kimchicon/BadgeHacking/PARTS/BADGE_PARTS_LIST.xlsx

 | 종류 | 모델명 | 개당(해외) | 개당(국내) | 주문개수 | 총 금액(해외) | 총 금액(국내) | 배송비 | URL
배송완료 | MCU | ATMEGA32U4 | $2.61 |  | 10pcs x 21개 | $652.63 |  | $45.52 | http://bit.ly/24hznVF
배송완료 | WIFI | ESP-12E | $2.04 |  | 10pcs x 21개 | $423.78 |  | $17.47 | http://bit.ly/1RT7o7r
배송완료 | TFT-LCD | ST7735 호환 | $3.29 |  | 210개 | $690.9 |  | $50 | http://bit.ly/1TNyb7s
배송완료 | 조이스틱 | KY-023 | $1.20 |  | 210개 | $252 |  | $22 | http://bit.ly/1sphjNz
배송완료 | 버튼 | PUSH BUTTON | $0.20 |  | 100pcs x 5개 | $42.50 |  | $30.13 | http://bit.ly/1Xbbxw0
배송완료 | 스위치 | Tact switch | $0.02 |  | 300개 | $5.16 |  | $30.13 | http://bit.ly/20Rgckx
배송완료 | 스위치 | SLIDE SWITCH (충전용) | $0.09 |  | 250개 | $19.40 |  | $15.06 | http://bit.ly/1U4exYg
배송완료 | 충전회로 | MCP73781 | $0.29 |  | 300개 | $83.43 |  | $40.00 | http://bit.ly/1Ur7IyD
배송완료 | REG | REG LDO 3.3 | $0.26 |  | 300개 | $51.87 |  | 묶음 배송 | http://bit.ly/1THVgZ7
배송완료 | 다이오드 | B340A | $0.04 |  | 500개 | $20 |  | $21.08 | http://bit.ly/1RICbnj
배송완료 | 크리스탈 | CSTCE 16Mhz | $0.37 |  | 220개 | $79.75 |  | $39.82 | http://bit.ly/1Y9wNBw
배송완료 | USB | USB-A | $0.11 |  | 210개 | $22.47 |  | $23.94 | http://bit.ly/1sueJ8V
배송완료 | 저항 | 10k | $0.01 |  | 600개 | $1.50 |  | $19.58 | http://goo.gl/MGPy3l
배송완료 | 저항 | 330 | $0.01 |  | 1000개 | $2.50 |  | 묶음 배송 | http://goo.gl/hWQtdl
배송완료 | 저항 | 22 | $0.01 |  | 600개 | $1.50 |  | 묶음 배송 | http://goo.gl/9OESeV,
배송완료 | 캐패시터 | 4.7uF | $0.02 |  | 400개 | $8.50 |  | $23.03 | http://goo.gl/saezLJ,
배송완료 | 캐패시터 | 0.1uF(100nF) | $0.01 |  | 700개 | $2.73 |  | 묶음 배송 | http://goo.gl/LYKlRL,
배송완료 | 캐패시터 | 1uF | $0.02 |  | 400개 | $4.24 |  | 묶음 배송 | http://goo.gl/xDU011,
배송완료 | 캐패시터 | 470pF | $0.01 |  | 400개 | 1.92 |  | $18.07 | http://goo.gl/welw40
배송완료 | 캐패시터 | 4.7uF | $0.02 |  | 600개 | $5.72 |  | 묶음 배송 | http://goo.gl/U0hsCX
배송완료 | LED | SMD TYPE | $0.20 |  | 600pcs x 4 | $ 26.60 |  | $22.76 | http://bit.ly/1UamMhJ
배송완료 | 핀 | 핀헤더 | $0.08 |  | 210개 | $17.00 |  | $30 | http://bit.ly/1YcdtDw
배송완료 | 핀 | 핀 커넥터 8 | $1.69 |  | 20pcs x 20 | $21.89 |  | $14.59 | http://goo.gl/okwCfy
배송완료 | 핀 | 핀 커넥터 4 | $0.05 |  | 140개 | $ 7.77 |  | $15.66 | http://goo.gl/9sksXs
배송완료 | 배터리 | LiPo 3.7V 1500mAh | $3.35 |  | 210개 | $667 |  | $92 | http://bit.ly/1WF3ZkC
배송완료 | 부저 | 피에조 부저 | $0.60 |  | 220개 | $117.48 |  | $18.07 | http://bit.ly/2a1lYSf
배송완료 | 쉬프트reg | 74HC595D (http://www.aliexpress.com/item/Free-shipping-10pcs-74HC595-SMD-logic-ics-74HC595D/32344291871.html) |  | 320 | 105개 |  | 33600 |  | http://www.devicemart.co.kr/1056859
배송완료 | 저항 | 330 |  | 200 |  |  | 4000 |  | http://www.devicemart.co.kr/25679
배송완료 | 저항 | 10m |  | 300 |  |  | 7000 |  | http://www.devicemart.co.kr/26851
배송완료 | 저항 | 10k |  | 200 |  |  | 4000 |  | http://www.devicemart.co.kr/25876
배송완료 | 커넥터 | 핀 커넥터 |  | 100 |  |  | 13750 |  | http://itempage.auction.co.kr/detailview.aspx?ItemNo=B300615427
배송완료 | LED | 8LED |  | 50 | 1800개 |  | 90000 |  | http://www.devicemart.co.kr/29835
배송완료 | 캐패시터 | 2.2uF |  | 19 | 600개 |  | 11400 |  | http://www.devicemart.co.kr/39625
배송완료 | 캐패시터 | 18pF |  | 7 | 200개 |  | 1400 |  | http://www.devicemart.co.kr/5166
배송완료 | 캐패시터 | 10nF |  | 7 | 200개 |  | 1400 |  | http://www.devicemart.co.kr/34758
배송완료 | 캐패시터 | 0.1uF(100nF) |  | 7 | 100개 |  | 700 |  | http://www.devicemart.co.kr/8088
배송완료 | 캐패시터 | 1nF |  | 7 | 700개 |  | 4900 |  | http://www.devicemart.co.kr/5196
배송완료 | 캐패시터 | 10pF |  | 7 | 100개 |  | 700 |  | http://www.devicemart.co.kr/5163
배송완료 | 캐패시터 | 20pF |  | 7 | 500개 |  | 3500 |  | http://www.devicemart.co.kr/5167
배송완료 | 캐패시터 | 10nF |  | 7 | 100개 |  | 700 |  | http://www.devicemart.co.kr/5210
배송완료 | 캐패시터 | 47nF |  | 14 | 100개 |  | 1400 |  | http://www.devicemart.co.kr/5213
배송완료 | 캐패시터 | 100nF |  | 90 | 200개 |  | 18000 |  | http://itempage.auction.co.kr/detailview.aspx?ItemNo=B293336125
배송완료 | USB | Micro USB B-type |  | 230 | 210개 |  | 55630 |  | http://itempage3.auction.co.kr/DetailView.aspx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
배송완료 | 목줄 | 1m USB 케이블 |  | 780 | 210개 |  | 179680 |  | http://bit.ly/1Y0Kwdy
 | PCB + SMT |  |  | 9500 |  |  | 2186250 |  | 한샘디지텍
 | 샘플 PCB 제작 |  |  |  |  |  | 184800 |  | 한샘디지텍
 | 합계 |  |  |  |  | 3666362.49 | $2802810.00 | 652763.28
 |  |  |  |  |  |  | 최종금액 | 7121935.77
