kimchicon/BadgeHacking/PINMAP/BADGE_PIN_MAP.xlsx

NAME | FUNCTION | CONNECTION
D0 | RXD1/AIN1/INT2 | ESP8266-TXD0
D1 | TXD1/INT3 | ESP8266-RXD0
D2 | SDA/INT1
D3 | OC0B/SCL/INT0 | SD-CS
D4 | ICP1/ADC8 | LED_CLOCK
D5 | OC3A | LED_DATA
D6 | T0/OC4D/ADC10 | BUZZER
D7 | INT6/AIN0 | SD-CS
D8 | ADC11/PCINT4 | LED_LATCH
D9 | PCINT5/OC1A/ADC12 | LCD-A0
D10 | PCINT6/OC1B/0C4B/ADC13 | LCD-RESET
D11 | PCINT7/OC0A/OC1C/RTS | LCD-CS
D12 | T1/ADC9 | touch_out
D13 | ICP3/CLK0/OC4A | touch_in
D14 | PDO/MISO/PCINT3 | SD/ISP
D15 | SCLK/PCINT1 | LCD/SD/ISP
D16 | PDI/MOSI/PCINT2 | LCD/SD/ISP
A0 | ADC7 | JOYSTICK-LEFT
A1 | ADC6 | JOYSTICK-UP
A2 | ADC5 | JOYSTICK_DOWN
A3 | ADC4 | JOYSTICK_RIGHT
A4 | ADC1 | BUTTON A
A5 | ADC0 | BUTTON B/ESP_GPIO0
