kimchicon/BadgeHacking/PCB/KIMCHICON_FINAL_SCHEMATIC.pdf

D

6 | 5 | 4 | 3 | 2 | 1

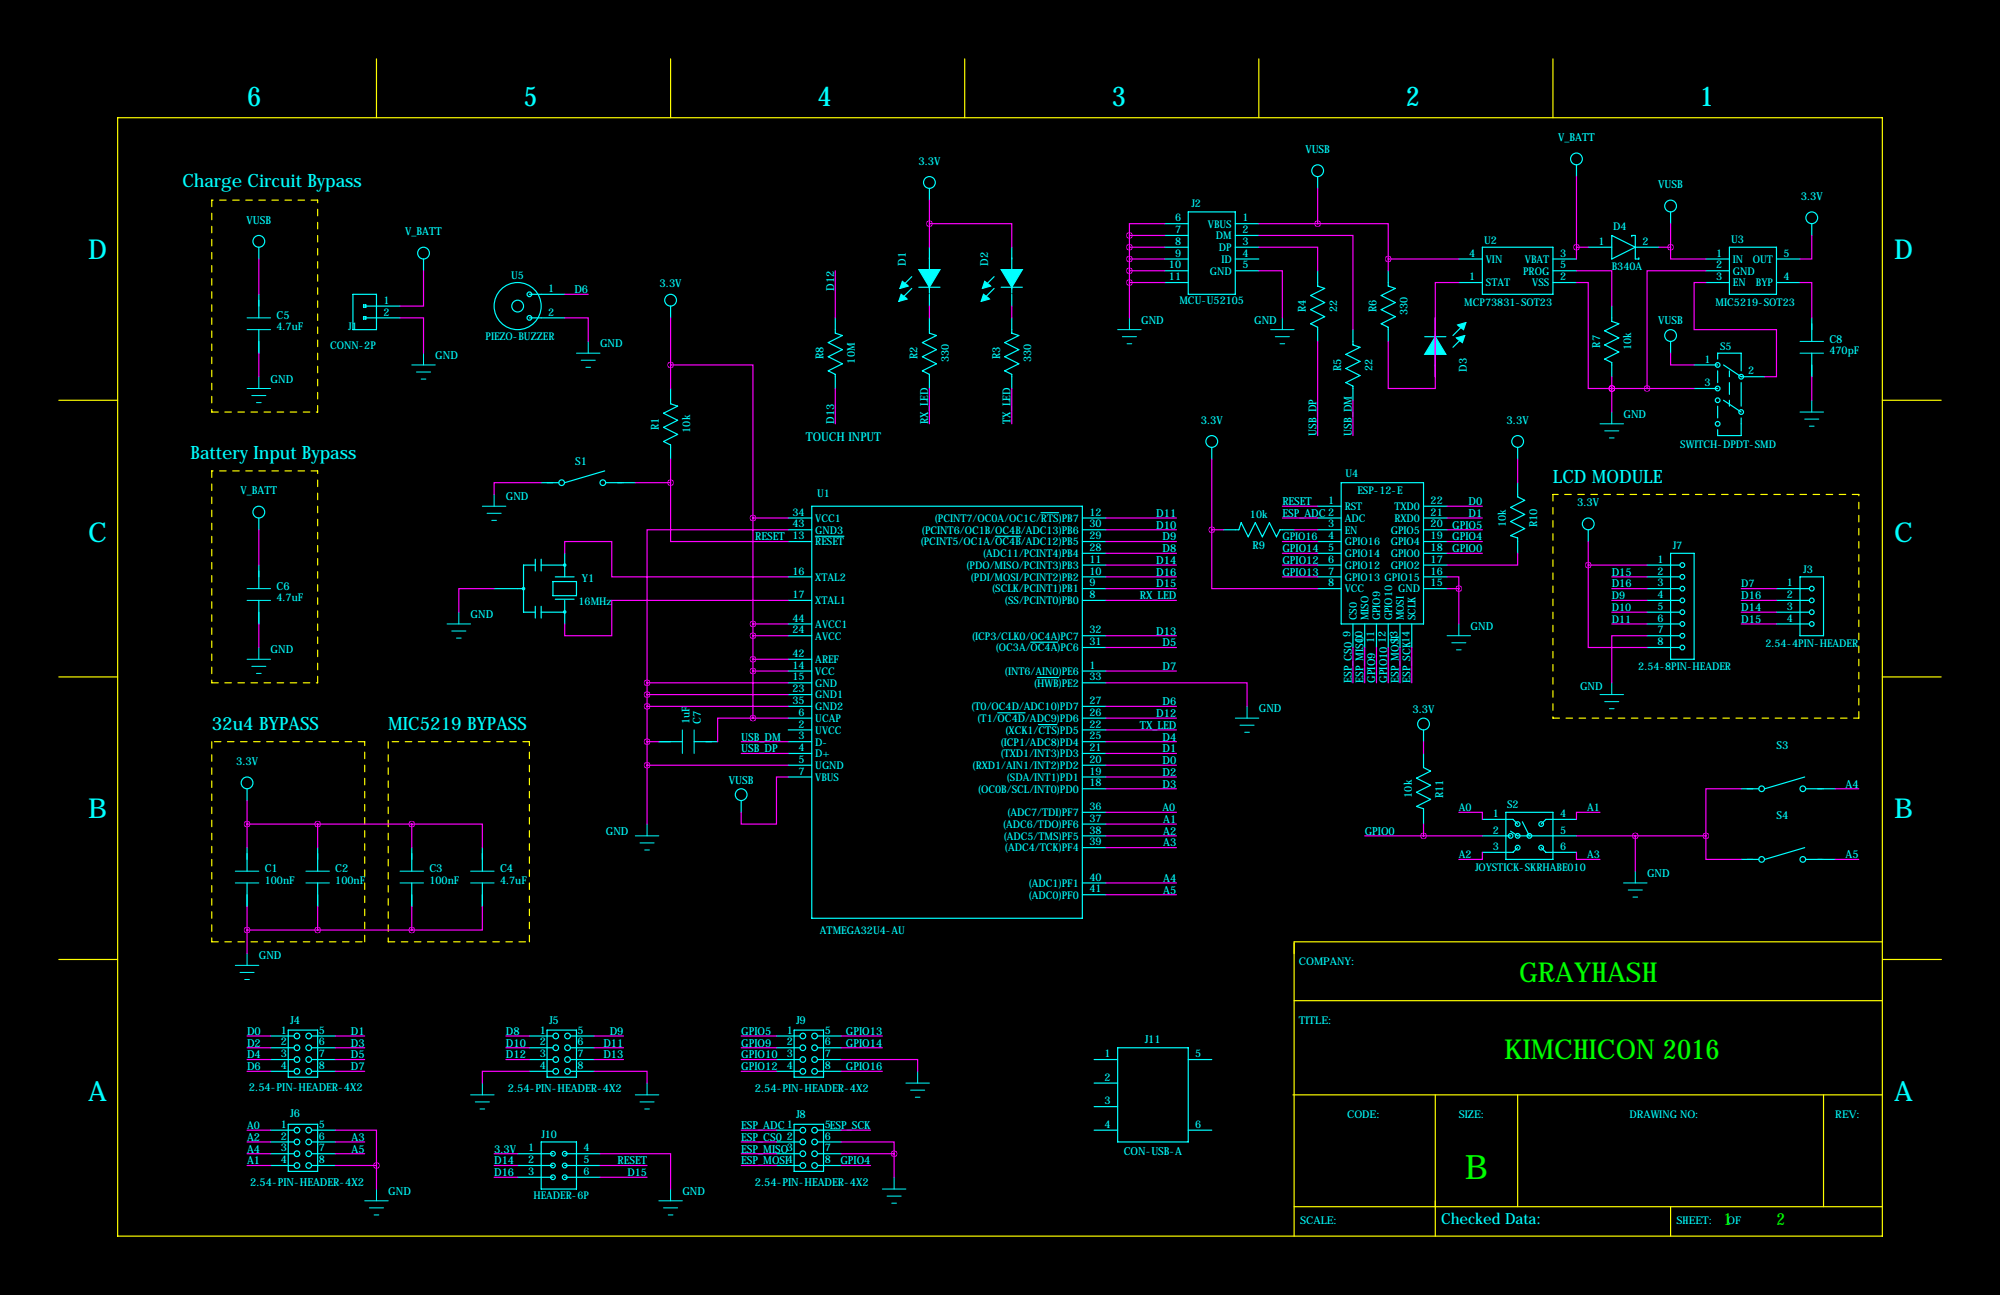
[picture p1: page 1]

CODE: | SIZE: B | DRAWING NO: | REV:

SCALE: | Checked Data: | 1 2 SHEET: OF

D

6 | 5 | 4 | 3 | 2 | 1

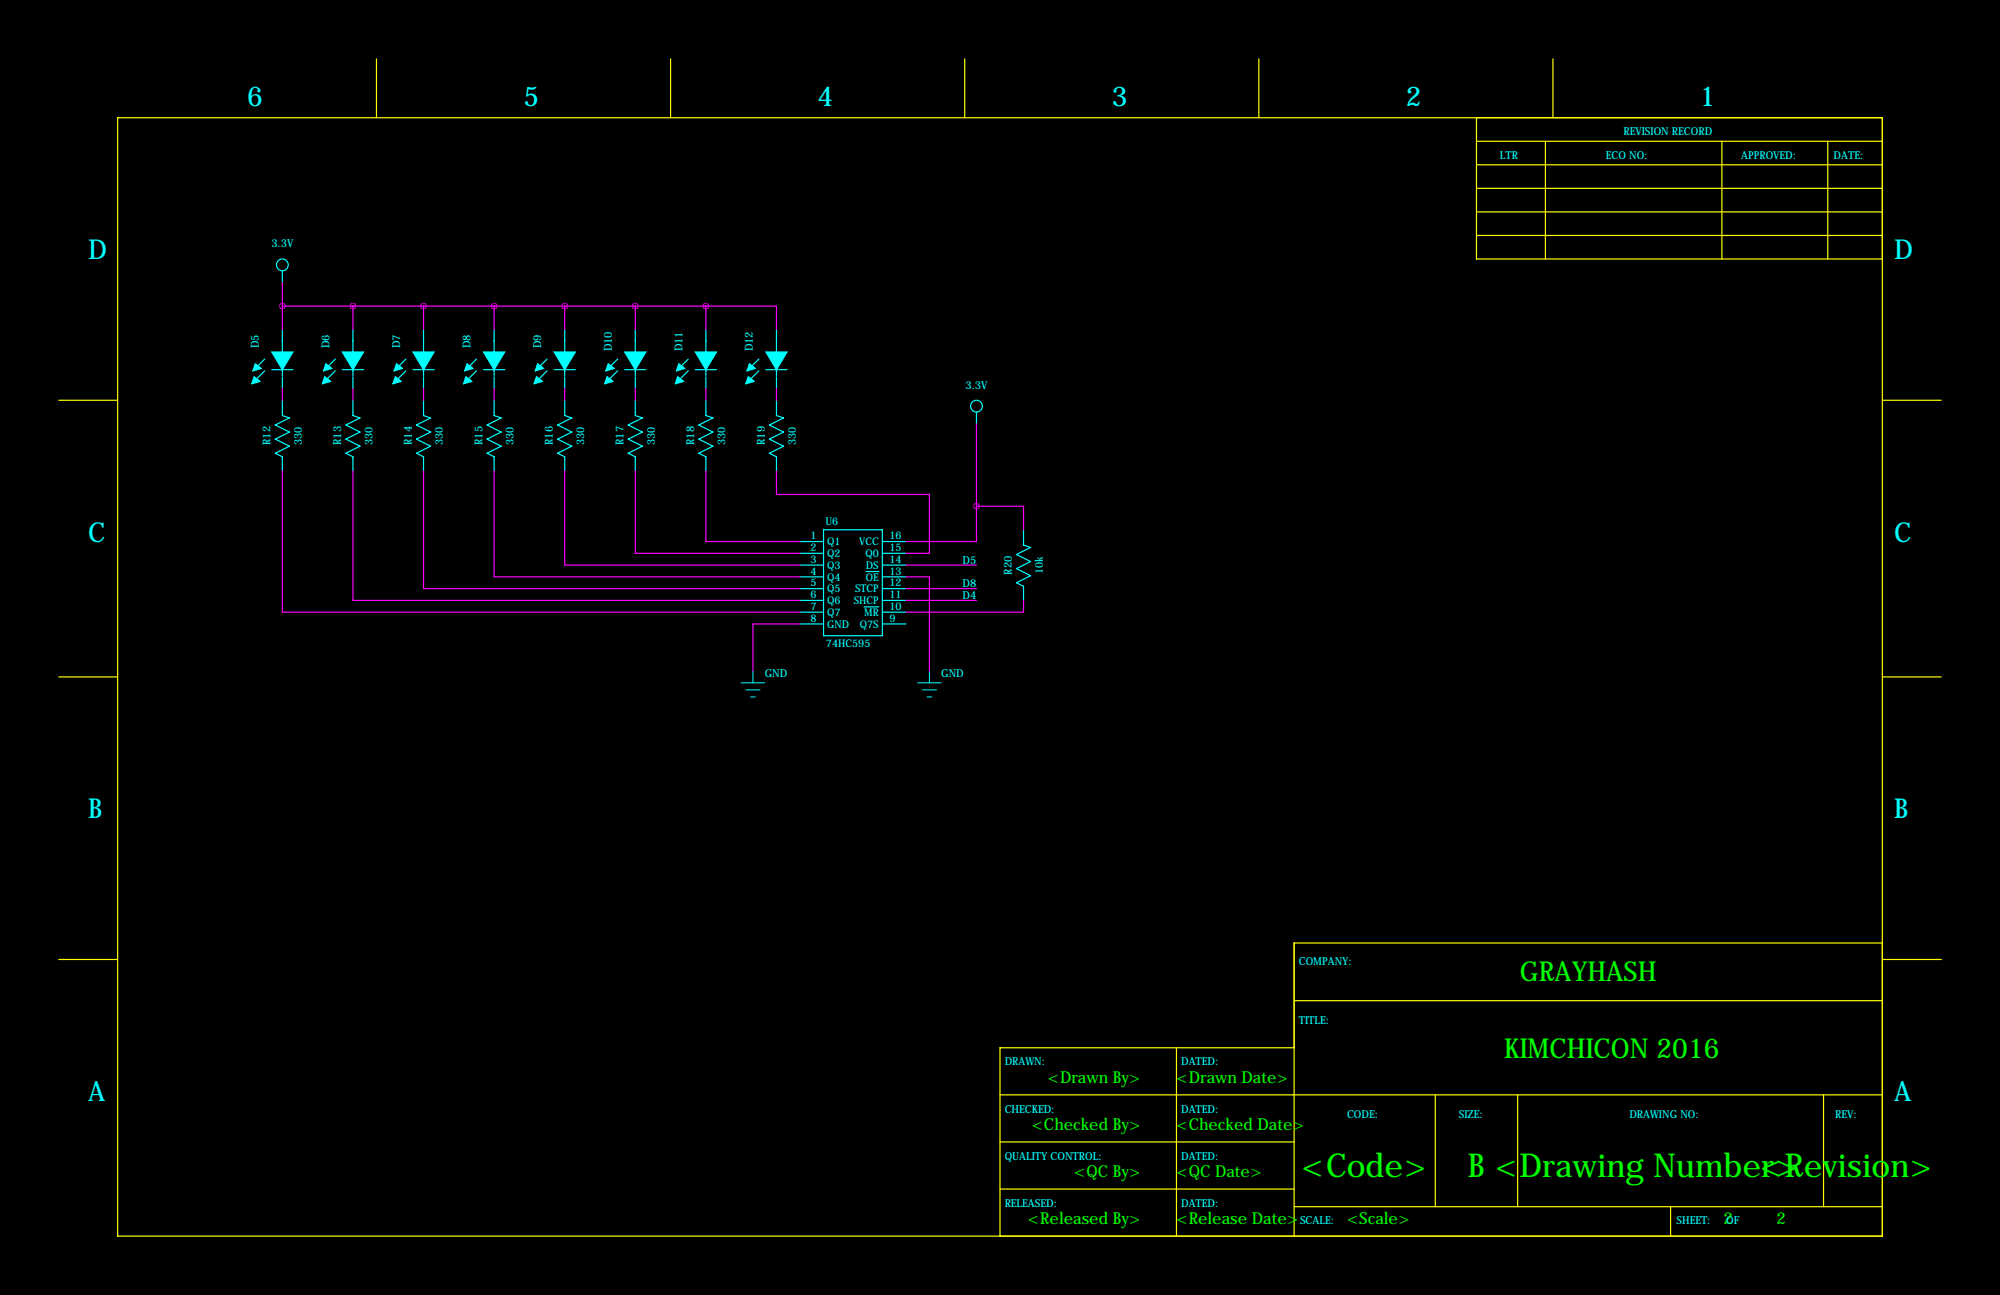
[picture p2: page 2]

REVISION RECORD

LTR | ECO NO: | APPROVED: | DATE:

Q4 5 | 12 STCP
Q5 6 | 11 SHCP | D4

DRAWN: <Drawn By> | DATED: <Drawn Date>

CHECKED: <Checked By> | DATED: <Checked Date> | CODE: | SIZE: | DRAWING NO: | REV:

QUALITY CONTROL: <QC By> | DATED: <QC Date>

RELEASED: <Released By> | DATED:

<Scale> SCALE: | 2 2 SHEET: OF
