kimchicon/BadgeHacking/PCB/KIMCHICON_FINAL_PCB.pdf

# C1C¹x1 C¹x2

# C5C⁵x1 C⁵x2

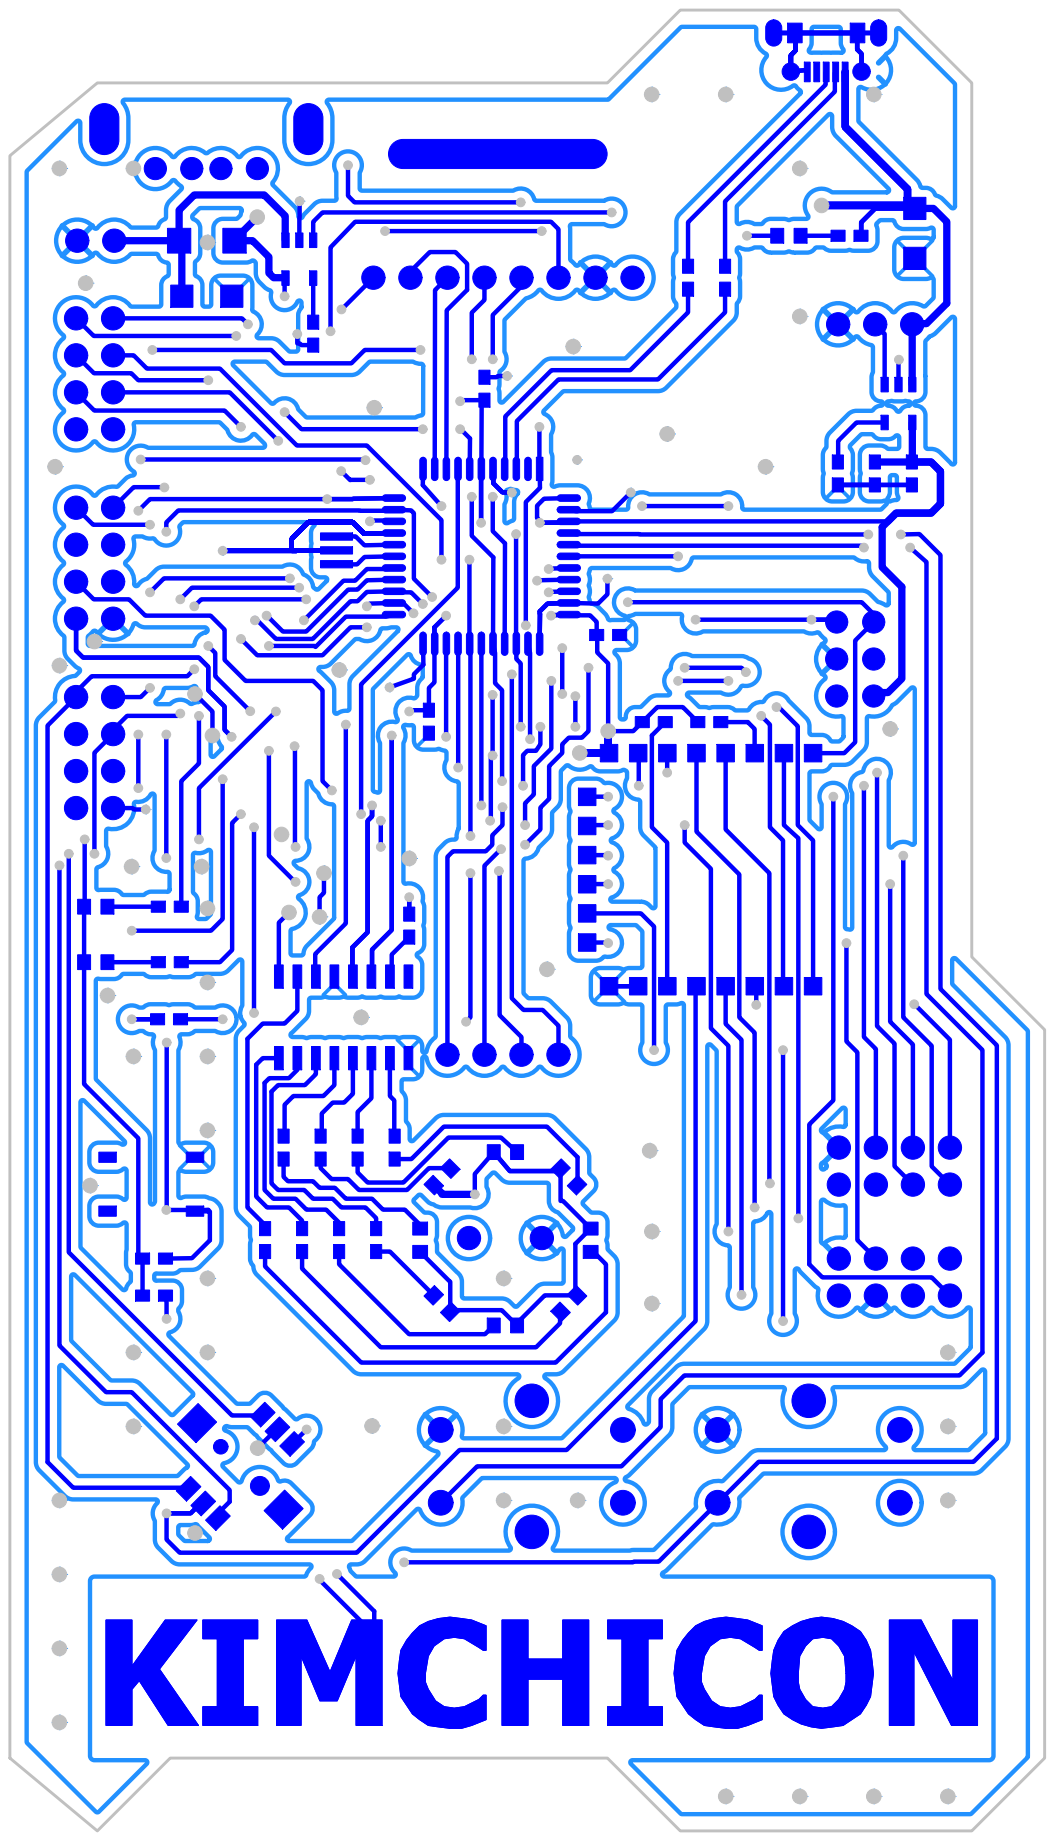
[picture p3: page 1]

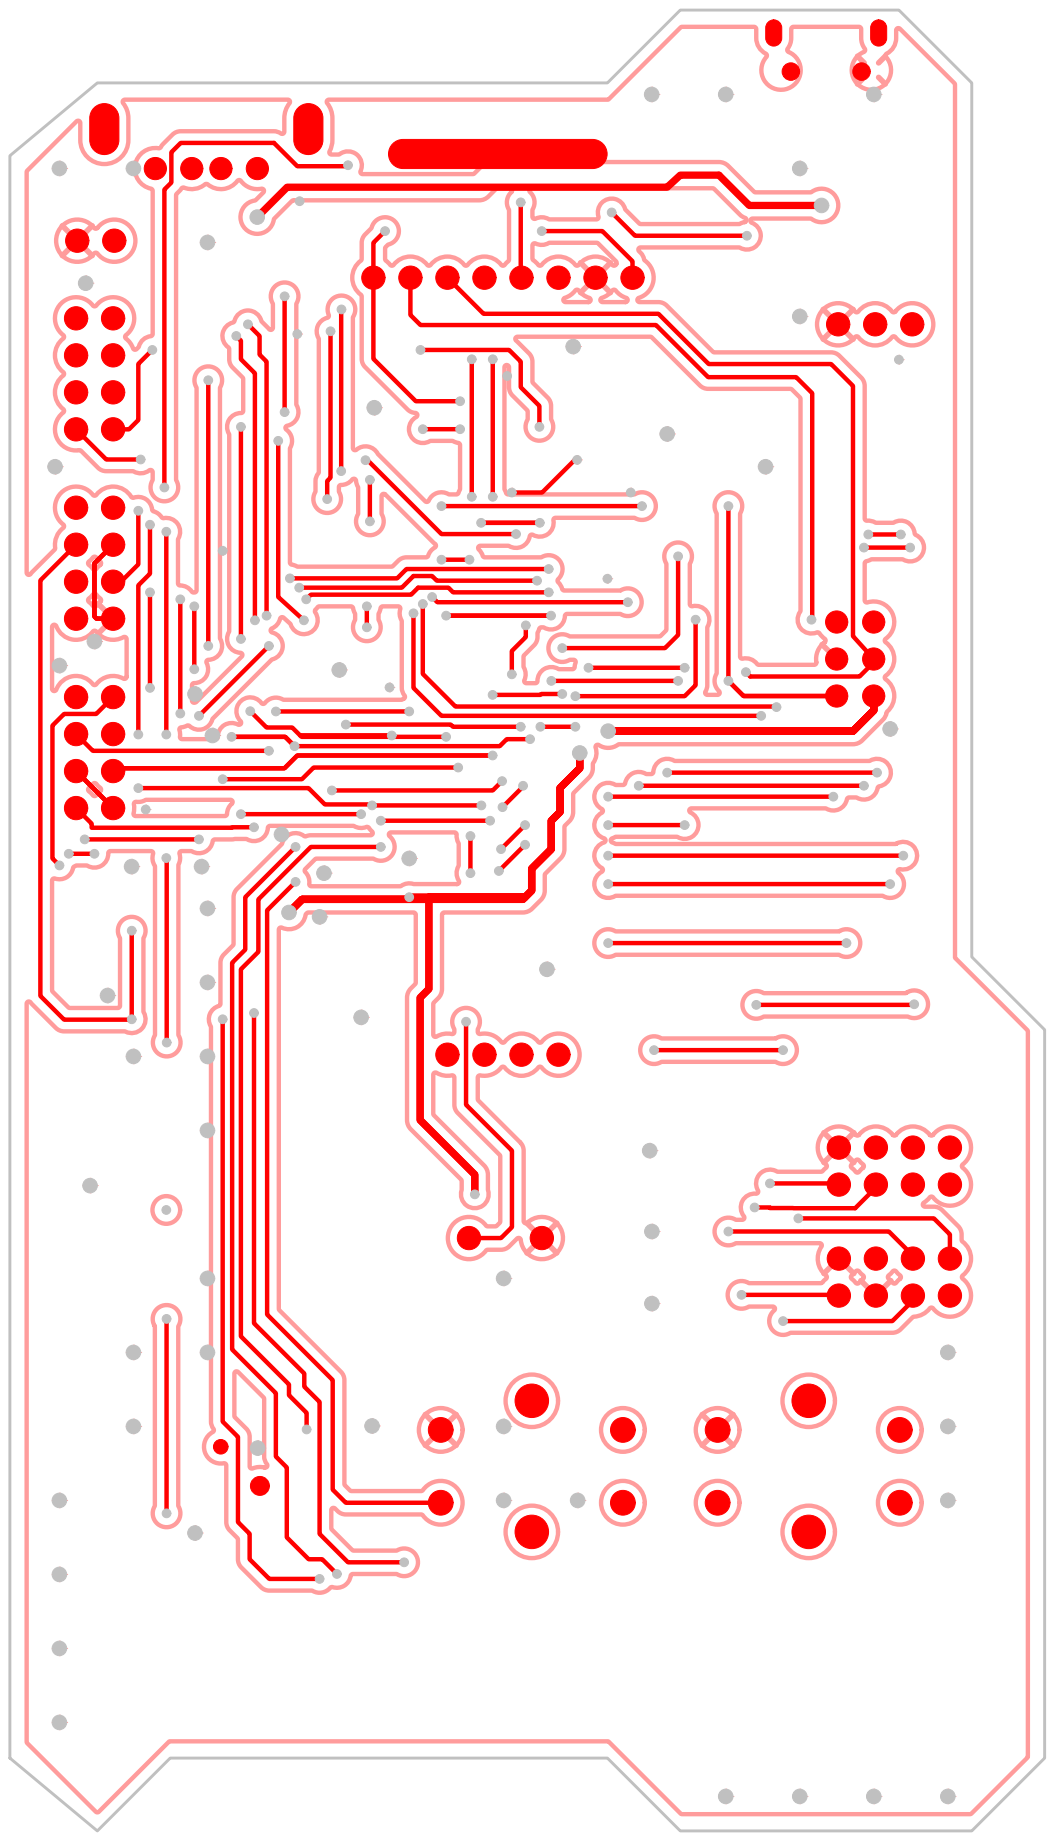
[picture p4: page 2]
S2S²x9 S²x10; S3S³x1 S³x2; S³x3 S³x4 S³x5 S³x6; S4S⁴x1 S⁴x2; S⁴x3 S⁴x4 S⁴x5 S⁴x6; U5U⁵x1; U⁵x2; S5S⁵x3; S⁵x2; S⁵x1

C6

J1

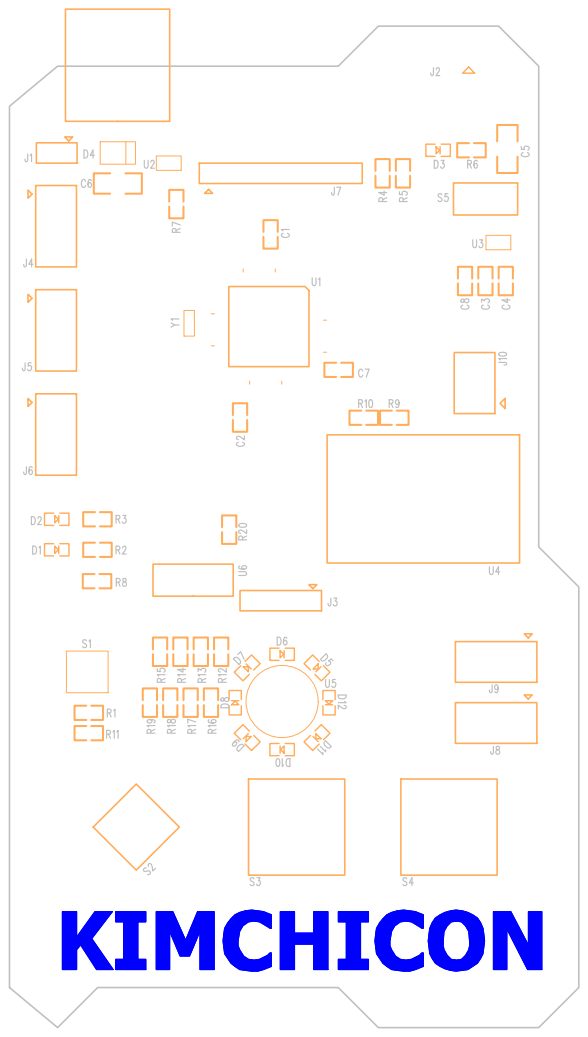
[picture p5: page 3]

# CHG ON

# BATT

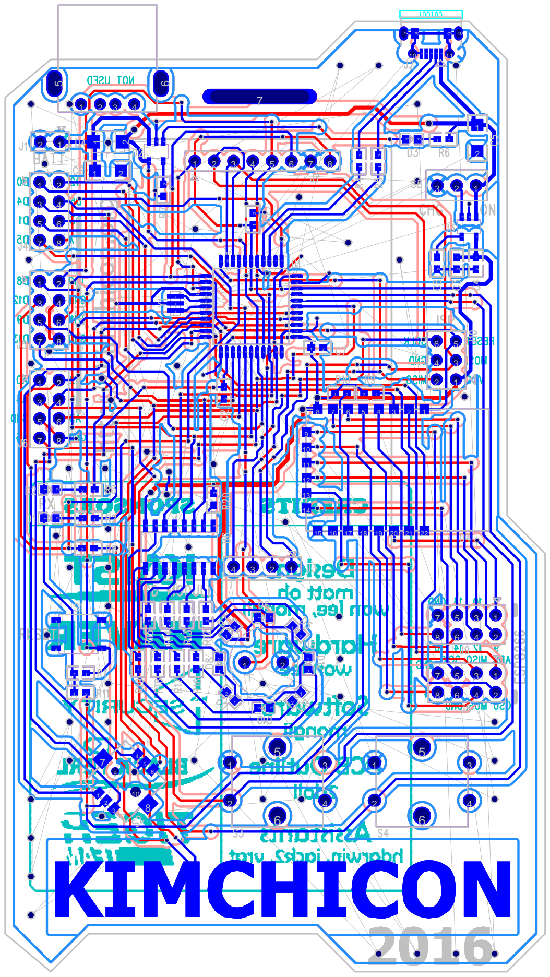
[picture p6: page 5]
