kimchicon/BadgeHacking/(list of files, drawings)

Other design files:
PCB/kimchicon_final.pcb
