kimchicon/BadgeHacking/(commit log)

2016-08-24 PCB added
    [kimchicon_final.pcb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]
2016-08-24 PARTS added
    [BADGE_PARTS_LIST.xlsx]
2016-08-24 pinmap, schematic added
    [BADGE_PIN_MAP.xlsx]
2016-08-24 pinmap added
    [BADGE_PIN_MAP.xlsx]
